Ivshti/flashing-lights/fab/control-board/control-board-BOM.csv

Comment | Designator | Footprint | LCSC Part # | Manufacturer Part | Qty | Note
18650 holder, PC pins | BT1,BT2 | BH-18650-PC (THT) |  | MPD BH-18650-PC | 2 | rear side
NTC 10k B3380 0603 (battery temp) | TH1 | 0603 | C13564 | NCP18XH103F03RB | 1
Fuse 7 A fast, 2410 (NANO2 451) | F1 | 2410 | C99548 | Littelfuse 0451007.MRL | 1
AO4407A P-MOSFET -30 V -12 A | Q1 | SOIC-8 | C16072 | AO4407A | 1
100k 1% 0402 | R1,R3,R11,R20,R22,R26,R28 | 0402 | C25741 |  | 7
AO3400A | Q2 | SOT-23 | C20917 | AO3400A | 1
1k 1% 0402 | R2,R14,R25 | 0402 | C11702 |  | 3
BAT54WS Schottky | D1,D2 | SOD-323 | C7502694 | BAT54WS | 2
SS34 Schottky 3 A | D3 | SMA | C8678 | SS34 | 1
USB-C 16P receptacle | J1 | TYPE-C-31-M-12 | C165948 | HRO TYPE-C-31-M-12 | 1
5.1k 1% 0402 | R4,R5 | 0402 | C25905 |  | 2
10k 1% 0402 | R6,R7,R10,R19,R21,R23,R24,R30,R33,R34,R35 | 0402 | C25744 |  | 11
USBLC6-2SC6 ESD | U6 | SOT-23-6 | C7519 | USBLC6-2SC6 | 1
BQ25887 2S boost charger | U2 | VQFN-24 4x4 | C2761614 | BQ25887RGER | 1
1uF 50V X5R 0603 | C1 | 0603 | C15849 |  | 1
10uF 25V X5R 0805 | C2,C3,C8,C21 | 0805 | C15850 |  | 4
1 uH Isat>=4.5 A 4x4 | L1 | 4x4 mm | C408332 | Sunlord MWSA0402S-1R0MT | 1 | same 4.4x4.2 outline as MWSA0412S
47nF 25V X7R 0402 | C4 | 0402 | C285062 |  | 1
4.7uF 16V X5R 0603 | C5 | 0603 | C19666 |  | 1
22uF 25V X5R 1206 | C6,C7,C10,C11,C13,C14,C15 | 1206 | C12891 |  | 7
47R 1% 2512 1 W (cell balancing) | R8 | 2512 | C146892 | CR2512F47R0E04Z | 1
300R 1% 0402 | R36 | 0402 | C25102 | 0402WGF3000TCE | 1 | rear side
390R 1% 0402 (ILIM ~2.85 A) | R9 | 0402 |  | UNI-ROYAL 0402WGF3900TCE | 1 | no LCSC number verified: pick any 390R 1% 0402
5.23k 1% 0402 | R12 | 0402 | C477746 | RC0402FR-075K23L | 1
30.1k 1% 0402 | R13 | 0402 | C29402 |  | 1
LED green 0603, Vf ~3 V (charging, fed from REGN) | D4 | 0603 | C72043 | Everlight 19-217/GHC-YR1S2/3T | 1 | rear side
TPS61089 12.6 V 7 A boost | U3 | VQFN-11 (RNR) | C165129 | TPS61089RNRR | 1
3.3 uH Isat 9.5 A 7x7 | L2 | 7.3x7.3 mm | C408446 | Sunlord MWSA0603S-3R3MT | 1
100nF 16V X7R 0402 | C12,C16,C22,C26,C28,C29,C30 | 0402 | C1525 |  | 7
2.2uF 16V X5R 0603 | C17 | 0603 | C23630 |  | 1
301k 1% 0402 (FSW 500 kHz) | R15 | 0402 | C2479392 | RMCF0402FT301K | 1
150k 1% 0402 (ILIM 6.9 A) | R16 | 0402 | C25755 |  | 1
15k 1% 0402 | R17 | 0402 | C25756 |  | 1
10nF 50V X7R 0402 | C18 | 0402 | C16193409 | Samsung CL05B103KB5VPJC | 1
22pF 50V C0G 0402 | C19 | 0402 | C1555 |  | 1
76.8k 1% 0402 | R18 | 0402 | C2076864 | ERJ-2RKF7682X | 1
1uF 16V X5R 0402 | C20,C27 | 0402 | C52923 |  | 2
AP63203 3.3 V 2 A buck | U4 | TSOT-23-6 | C780769 | AP63203WU-7 | 1
4.7 uH Isat 2.2 A 4x4 | L3 | 4x4 mm | C17700155 | Sunlord MWSA0412S-4R7MT | 1 | 3V3 load < 0.7 A
22uF 25V X5R 0805 | C23,C24 | 0805 | C45783 |  | 2
ESP32-S3-WROOM-1 N8 | U5 | module | C2913198 | ESP32-S3-WROOM-1-N8 | 1 | rear side; standard PCBA
10uF 10V X5R 0805 | C25 | 0805 | C15850 |  | 1 | rear side
LED red 0603 (status) | D5 | 0603 | C2286 | KT-0603R | 1 | rear side
33k 1% 0402 | R27 | 0402 | C25779 |  | 1
22k 1% 0402 | R29 | 0402 | C25768 |  | 1
2.2k 1% 0402 | R31,R32 | 0402 | C25879 |  | 2
Tactile 6x6 mm, 13 mm tall | SW1,SW2,SW3,SW4 | 6x6 THT | C223774 | HRO K2-1102DP-S4SW-04 | 4 | rear side, THT
