Ivshti/flashing-lights/fab/led-board/led-board-BOM.csv

Comment | Designator | Footprint | LCSC Part # | Manufacturer Part | Qty | Note
LED 3535 RGBA 4-in-1, 350 mA/die | D00,D01,D02,D10,D11,D12,D20,D21,D22,D30,D31,D32 | LED3535-8 (custom) |  |  | 12 | Not on LCSC: generic ceramic 3535 RGBA 4x1 W, consigned. Verify pinout against hardware/lib/led3535.tsx
0R jumper 2512 | JV0,JV1,JV2,JV3,JVC | 2512 | C2074834 | Bourns CR2512-J/-000ELF | 5 | carries one column, <= 0.7 A
AO3400A | Q0R,Q0G,Q0B,Q0A,Q1R,Q1G,Q1B,Q1A,Q2A,Q2B,Q2G,Q2R,Q3A,Q3B,Q3G,Q3R | SOT-23 | C20917 | AO3400A | 16
LMV321 (TI pinout: 1=IN+ 2=V- 3=IN- 4=OUT 5=V+) | U0R,U0G,U0B,U0A,U1R,U1G,U1B,U1A,U2A,U2B,U2G,U2R,U3A,U3B,U3G,U3R | SOT-23-5 | C7972 | LMV321IDBVR | 16 | TI original only: clones differ in pinout
0.33R 1% 1206 0.25 W | RS0R,RS0G,RS0B,RS0A,RS1R,RS1G,RS1B,RS1A,RS2A,RS2B,RS2G,RS2R,RS3A,RS3B,RS3G,RS3R | 1206 | C22393 | RL1206FR-070R33L | 16
100R 1% 0402 | RG0R,RG0G,RG0B,RG0A,RG1R,RG1G,RG1B,RG1A,RG2A,RG2B,RG2G,RG2R,RG3A,RG3B,RG3G,RG3R | 0402 | C25076 |  | 16
100k 1% 0402 | RP0R,RP0G,RP0B,RP0A,RP1R,RP1G,RP1B,RP1A,RP2A,RP2B,RP2G,RP2R,RP3A,RP3B,RP3G,RP3R | 0402 | C25741 |  | 16
27k 1% 0402 | RT0R,RT0G,RT0B,RT0A,RT1R,RT1G,RT1B,RT1A,RT2A,RT2B,RT2G,RT2R,RT3A,RT3B,RT3G,RT3R | 0402 | C25771 |  | 16
1k 1% 0402 | RB0R,RB0G,RB0B,RB0A,RB1R,RB1G,RB1B,RB1A,RB2A,RB2B,RB2G,RB2R,RB3A,RB3B,RB3G,RB3R | 0402 | C11702 |  | 16
100nF 16V X7R 0402 | CD0R,CD0G,CD0B,CD0A,CD1R,CD1G,CD1B,CD1A,CD2A,CD2B,CD2G,CD2R,CD3A,CD3B,CD3G,CD3R,C1 | 0402 | C1525 |  | 17
0R jumper 1206 | JP0R,JP0G,JP0B,JP0A,JP1R,JP1G,JP1B,JP1A,JP2A,JP2B,JP2G,JP2R,JP3A,JP3B,JP3G,JP3R | 1206 | C17888 | 1206W4F0000T5E | 16
PCA9685PW | U1 | TSSOP-28 | C2678753 | PCA9685PW,118 | 1
1uF 10V X5R 0402 | C2 | 0402 | C52923 |  | 1
NTC 10k B3380 0603 | RT1 | 0603 | C13564 | NCP18XH103F03RB | 1
