Ivshti/flashing-lights/(commit log)

2026-10-01 Add initial design decisions and power budget calculator
    Covers JLC metal-core constraints (single layer, two-board stack),
    RGBW LED and array sizing, 1S vs 2S runtime estimates, optics and
    regulatory notes.
    Claude-Session: https://claude.ai/code/session_0189Ee3kAgcQDm9DK4EsBqc5
2026-10-01 LED board: hand-routed single-layer MCPCB with RGBA array and current sinks
    - tscircuit board with 12x 3535 RGBA LEDs, 16 LMV321/AO3400A sinks and a
    PCA9685, all copper placed procedurally (planar, 0R jumpers)
    - pcbflow tools: Freerouting DSN/SES bridge, geometric DRC, PNG preview,
    JLC gerber/BOM/CPL export
    - vendored KiCad footprints converted to tscircuit
    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
    [led-board-BOM.csv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]
2026-10-01 WIP control board: placement, netlist, Freerouting setup with GND plane
    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
2026-10-02 Control board: hand-routed VBOOST feed, U3 GND via, plane-via skip list
    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
2026-10-02 Fab export: KiCad-style G85 slots, drop fab layers; gerber checks for slots, outline and single layers; sink thermal notes
    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
2026-10-02 Control board: hand-route boost FB/VBOOST tap, VSYS/VBUS escape vias; DRC edge and fab-minimum checks; copper probe tool
    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
2026-10-02 Control board: move ESP32 cluster right so the antenna keep-out clears BT2; move R22 out of the VBOOST tap loop
    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
2026-10-02 Control board: datasheet-checked charger/boost values (ILIM 390R, SNS 2x22uF, MID 300R, comp 10nF), NANO2 fuse land, LCSC numbers for both BOMs
    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
2026-10-02 LED board: refresh fab BOM with LCSC numbers
    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
    [led-board-BOM.csv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]
2026-10-02 Multi-size vias in DSN/SES, hand fan-out for BQ25887 west pins; document LED sourcing (consigned 3535 RGBA)
    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
    [led-board-BOM.csv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]
2026-10-02 Power nets restricted to outer layers (use_layer) + DRC rule; hand-route VBUS (bottom, 1 mm) and VBATF to C8
    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
2026-10-02 Control board: hand-route VBATF charger branch on the bottom layer
    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
2026-10-02 Editable fan-out stubs for Freerouting connectivity; README ordering/status
    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
2026-10-02 Control board fully routed: 0 unconnected, 0 DRC violations; JLC fab outputs, saved Freerouting session + replay, previews, final docs
    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
    [control-board-BOM.csv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]
